Tronix286/a2vga_audio/docs/photo_2024-11-19_14-51-54.jpg

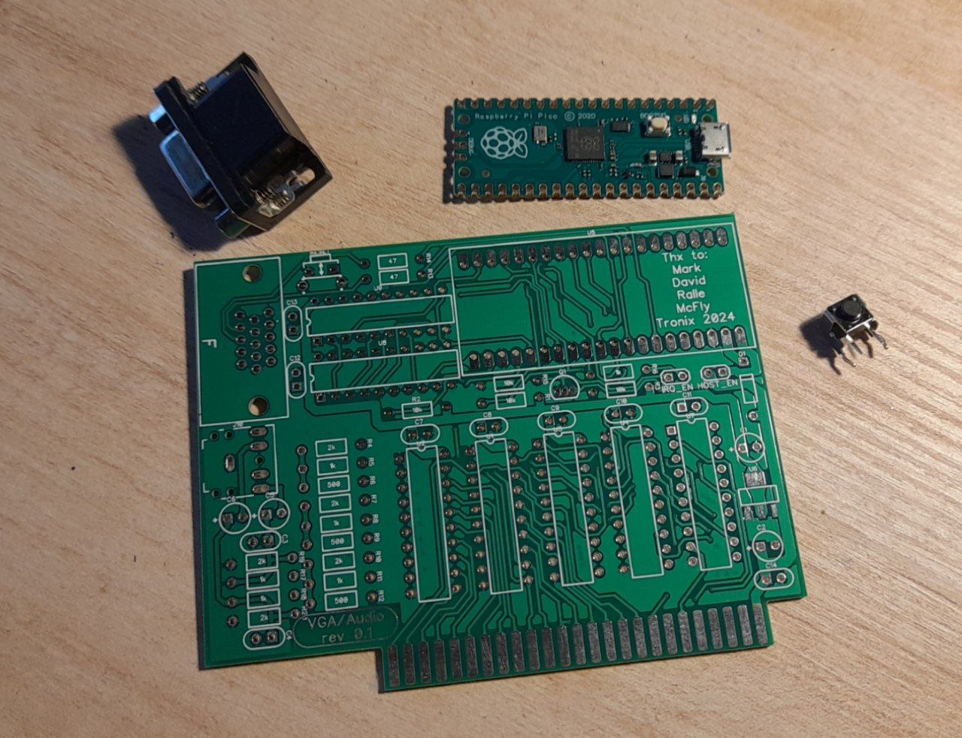
docs/photo_2024-11-19_14-51-54.jpg
