Tronix286/a2vga_audio/docs/photo_2024-11-20_11-59-58.jpg

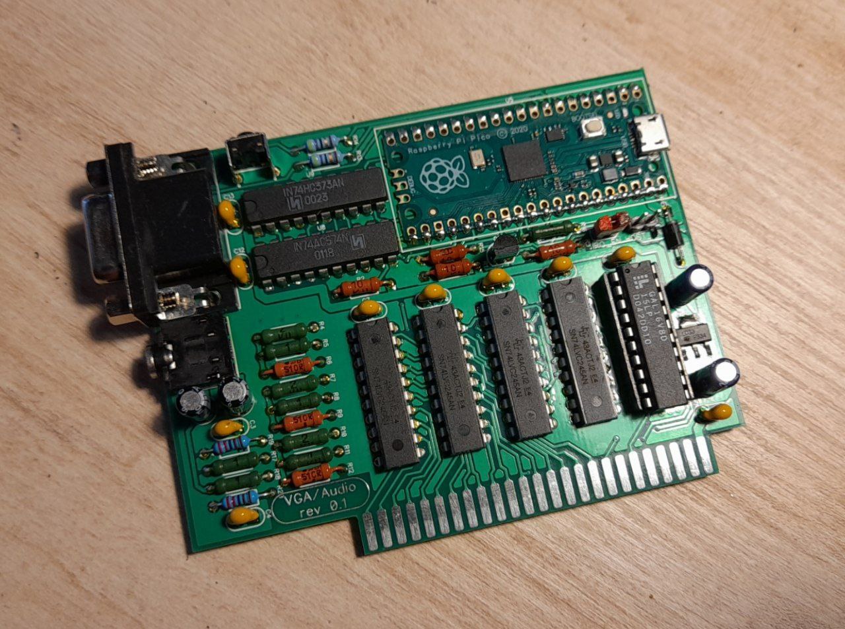
docs/photo_2024-11-20_11-59-58.jpg
