Tronix286/a2vga_audio/docs/photo_2024-11-20_12-00-19.jpg

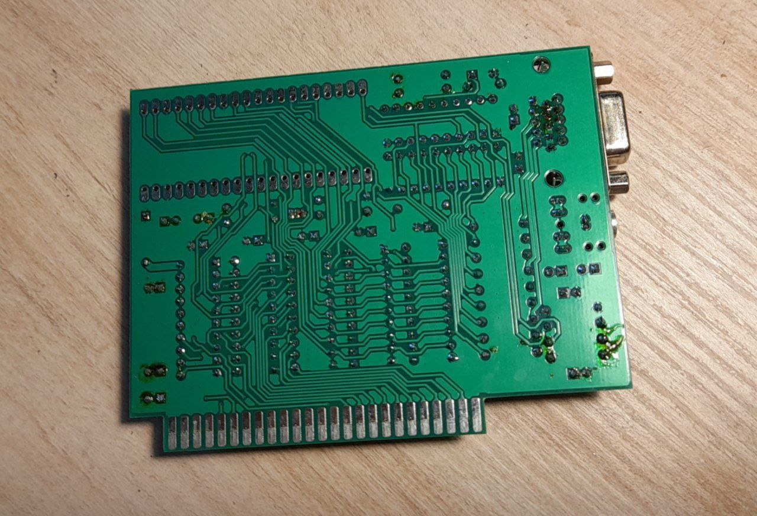
docs/photo_2024-11-20_12-00-19.jpg
