Tronix286/a2vga_audio/(threads)

Thread 1 (2025-02-06):

Components

amazingcobrazil, 2025-02-06:
Hello,
I'm finishing assembling my board but I have some questions:
1) What is the value of diode D1? 1N4001?
2) The schematic says that ICs U1, U2, U3 and U4 are 74HC245 and in the photos of your board you used 74LVC245 (much harder to find). Can I use HC?

Tronix286, 2025-02-06:
Hello,
I am using schottky 1N5817 but that doesn't matter. 1N4001 will do just fine.
U1,U2,U3 and U4 iam using 74LVC245. I'm not sure that 74HC245 will work, I haven't checked. Maybe yes, maybe no. It's better to use LVC series.

amazingcobrazil, 2025-02-06:
What about the firmware? Which of them is available that already works with the Mockingboard? Will the board work with both features together? (VGA + Mockingboard) or will it have to work separately by changing the firmware?
Congratulations on the project!

Tronix286, 2025-02-07:
> What about the firmware? Which of them is available that already works with the Mockingboard? Will the board work with both features together? (VGA + Mockingboard) or will it have to work separately by changing the firmware? Congratulations on the project!

Two options:
1) a2vga+mockingboard. First step you need burn [v2-analog-preloader.uf2](firmware/Release/v2-analog-preloader.uf2) It will prepare and install the fonts into pico flash and then blink the LED a couple of times. Then second step is burn [v2-analog-lc-4ns-vga.uf2](firmware/Release/v2-analog-lc-4ns-vga.uf2) - its main a2vga+mockingboard firmware. Set the jumper IRQ_EN to ON. Install card into slot #4. Thats all, you get VGA output plus Mockingboard at the same time.
2) Original Apple II VGA firmware modified for this PCB. Burn [applevga.uf2](firmware/Release/applevga.uf2). Its NOT support Mockingboard, VGA output only. But if the Videx 80 column card is installed this firmware can display 80x25 text mode (PR#3) and the previous firmware (a2vga+mockingboard) can't do it.

Firmware for GAL16V8 you can download from [∀2 Retro Computing](https://github.com/V2RetroComputing/analog), so direct link is [picopal](https://github.com/V2RetroComputing/picopal-v1/blob/dbde4b1a4bb3d2647ef39bca39bba3fad3cf1425/picopal.pld)

amazingcobrazil, 2025-03-14:
I would like to thank you in advance for your help. I was able to finalize my board for testing. I had the following situations on my board:

1) The colors of the firmware I downloaded here are apparently in PAL standard. Note in the photos I attached that in Karateka the image in the background is green instead of blue in the NTSC of another VGA board. Would it be possible to add another Firmware to the project or tell me where I can change this?

2) In the Mockingbird option I was able to make it work in very few games. In fact I only managed to do it in a demonstration from “Canada” that I found here on GitHub. Could you tell me what model of the emulated board would be? Who developed this firmware that runs on your board? It would be great if they found a way to increase board compatibility. Could you tell me which games you were successful in? I saw your test on YouTube but I couldn't get Última IV to run on mine. What other game did you use in the test?

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

Tronix286, 2025-03-14:
> 1. The colors of the firmware I downloaded here are apparently in PAL standard. Note in the photos I attached that in Karateka the image in the background is green instead of blue in the NTSC of another VGA board. Would it be possible to add another Firmware to the project or tell me where I can change this?

Original a2vga PIOs worked at a pixel clock frequency of ~25 MHz, then when sequentially loading values   into two registers in my board, a frequency twice as high is required - 50 MHz(!). This is most likely almost the maximum frequency for the 74**HC** IC series, so it is better to use something faster, for example, the 74AC or 74ACT series. Thus, for proper color decoding very important use "fast" logic IC for U8 (74xx574), U9 (74xx373). In my case I used what I had on hand, namely 74HC373 and 74AC574.  At your photo, chip 74**LS**373 will **not work** as expected i think. Try to change this with 74**HC**373. Thats all you need for proper color decoding.

> 2. In the Mockingbird option I was able to make it work in very few games. In fact I only managed to do it in a demonstration from “Canada” that I found here on GitHub. Could you tell me what model of the emulated board would be? Who developed this firmware that runs on your board? It would be great if they found a way to increase board compatibility. Could you tell me which games you were successful in? I saw your test on YouTube but I couldn't get Última IV to run on mine. What other game did you use in the test?

Unfortunately there are not many games that support Mockingboard. I don't remember all the games I've tried, there is a table of games that support mockingboard somewhere on the net. Sometimes in games you need to press a key combination like CTRL+S or something else to activate the mockingboard. Sometimes a special version of the game that supports mockingboard is required and this version is not always available on the Total Replay collection. I have heard sound to some extent in games like:
- Apple Cider Spider (ctrl+b for MB activation)
- Berzap! (ctrl+c for sound options)
- Bouncing Kamungas (ctrl+s for MB)
- Flak (special version)
- Lady Tut (special version, need 65C02 CPU for load)
- Lancaster (special version)
- Mapple
- Night Flight / Battle Cruiser SMS 2000
- One on One
- Skyfox (need joystick?)
- Spy Strikes Back!, The
- Thunder Bombs (ctrl+s act MB)
- Ultima IV – Quest of the Avatar
- Ultima V – Warriors of Destiny (need Apple IIe/c)
- Willy Byte in the Digital Dimension

Iam author of MB emulation code for a2vga firmware. I emulate "Mockingboard A".

Thread 2 (2025-03-21):

missing colors on vga output?

timspc1980, 2025-03-21:
Hi and thanks for this cool project,only just getting back into the A2 so I have managed to put one of these together but the colors dont look correct (almost like its missing a few colors) and there is a blue fringe around text which is not white but rather purple/dark pink?

Have tried different logic chip series for U8 and U9 (74HC/74HCT/74F) but no change? I am waiting for some AC/ACT to test as per your recommendation but can you confirm the colors on your card is working? Any other things to look at ?

FYI - Q1 (c9013) I could only find 2n3904 in my parts bin would this be ok as a replacement?

The mockingboard part is working well, great sound brings back memories from the past when I had one, love it!

Thanks

Tronix286, 2025-03-21:
> Hi and thanks for this cool project,only just getting back into the A2 so I have managed to put one of these together but the colors dont look correct (almost like its missing a few colors) and there is a blue fringe around text which is not white but rather purple/dark pink?
> Have tried different logic chip series for U8 and U9 (74HC/74HCT/74F) but no change? I am waiting for some AC/ACT to test as per your recommendation but can you confirm the colors on your card is working? Any other things to look at ?

Hm.... In my opinion, there are possible reasons:
 1) the firmware is not from this page, perhaps the original a2vga or some other one. It is necessary to make sure that the pipico is flashed with the firmware from this page from the [this section](firmware/Release) . First flash [v2-analog-preloader.uf2](https://github.com/Tronix286/a2vga_audio/blob/main/firmware/Release/v2-analog-preloader.uf2) then burn main a2vga+audio formware [v2-analog-lc-4ns-vga.uf2](https://github.com/Tronix286/a2vga_audio/blob/main/firmware/Release/v2-analog-lc-4ns-vga.uf2) . Also you can try [applevga.uf2](https://github.com/Tronix286/a2vga_audio/blob/main/firmware/Release/applevga.uf2) - this firmware dosnt support mockingboard, but compiled for this PCB exactly.
2) yes,  U8 and U9 should be as fast as possible. Sometimes the Chinese re-mark the chips, so if you order them from AliExpress, it is not a fact that the marking corresponds to the real chip. They can sell HC as LS marking or vice versa. Therefore, original fast chips are needed, HC (not sure) or AC or ACT series.
3) check the soldering, and that the resistors match the required ratings.
4) Your PiPico does not support overclocking well. The thing is that my firmware works with overclocking, unlike the original a2vga firmware, and I heard that not all PiPico boards tolerate overclocking well. On the other hand, if you see a picture on the monitor, then your PiPico works at the required frequencies. So it is unlikely.

Can you provide examples of pictures on your system?
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

Q1 is needed for IRQ generating circuit for mockingboard emulation, so if you hear sounds then the transistor Q1 is fine.

timspc1980, 2025-03-22:
hi again and thanks for replying...

1. I used your uf2 files , tried both vga+mock and vga only and both show same color output almost washed out/dull with a blue tinge around the text? I did notice the vga only fw shows % sign instead of IIe, not sure why as the vga+mock shows correctly... I used the picopal.jed file from original a2analog. FYI Im using a USA NTSC IIe enh

2. Parts are all genuine from mouser here in usa inc the pico ;-), and yes the mockingboard side functions perfectly.
3. soldering all good I checked with your schematic everything correct

4.I did do a test by powering up the card via the pico usb and connected to vga monitor (outside of the apple) and the a2 logo with IIe computer display came up all in red and a red box next to it?

The only thing I can think of is that the resistors used are a mix of 1% and 5% tolerance would this cause an issue with the color output ? Also I only had a 510R resistor instead of 500R.

Will test with AC/ACT series and report back and I try put some pics up

timspc1980, 2025-03-23:
Hi, I checked data sheets of the series used on your card (U8 HC/ U9 AC) and the speeds are very close to the series I tested (HC/HCT and F series) but I may have some LVC from some old pc cards that I will try find, they are even faster. But I agree if you can test your card using different series would help.

BTW I did notice your card is Ver 0.1? Has anything changed in Ver 0.2 or have you been able to build a Ver 0.2 to test.

Tronix286, 2025-03-25:
> BTW I did notice your card is Ver 0.1? Has anything changed in Ver 0.2 or have you been able to build a Ver 0.2 to test.
Hi, нhe only difference between the second revision and the first is the adjusted size of the edge card connector. In the first version, the edge slot was smaller than necessary in width, in the second version the indents are aligned. There are no other differences. I myself did not order or assemble the second version.

Tronix286, 2025-03-25:
> But I agree if you can test your card using different series would help.

Unfortunately, I don't have the opportunity to buy any original series of 74 logic IC now. But I found several options:
U8
IN74AC574AN - "Integral", Belarus
SN74HCT574N - "Texas Instruments"

U9
IN74HC373AN - "Integral", Belarus
K555IR22 - "USSR", 74LS373 analog
GD74LS373 - "GoldStar"

So,
IN74HC373AN + IN74AC574AN = fine color, white text on black screen; REFERENCE;
555IR22 + IN74AC574AN = white text with a blue fringe around text;
GD74LS373 + IN74AC574AN = yellow text on black screen, missing colors;
and
IN74HC373AN + SN74HCT574N = white text with a red fringe around text;

For some reason i cant attach sample images now. But experiments have shown that the IN74HC373AN + IN74AC574AN works best. Any other chips i have didn't work as they should.

timspc1980, 2025-04-05:
Thanks so much for testing different series , I have tried a number of different combinations with parts I have and color is good now :-) thanks again for great project!

Closed 2025-04-05.

Thread 3 (2025-05-21):

Proposals

greukik, 2025-05-21:
Hello.
I just finished mounting this card. The vga output is amazing, thanks!

May I ha umbly suggest to update the readme file with some important informations hard to find without looking at the schematics on a dedicated software.
Some answers are indeed in the other issue question.

My difficulties were:
No BOM (but I managed to make one , looking at the technical schemes)

No GAL .jed file. You gave in the issue questions a link to a non compiled file and the compiler wincupl is not available anymore on microchip website. Had some difficulties to make a .jed file for the t48 while wincupl is currently not so easy to find on the web... And it asked a serial number... That is given on the microchip forum 🤡. So much time lost  😁.

Some minor corrections (R 500 is in fact a R 510) and some caps are noted only "0.1" without unity. By default my hypothesis was uF but some of them are noted 100nF so it was confusing for a non professionnal like me. Didn't want to make mistakes.
And finaly, could you explain the role of the 2 jumpers?

By the way, it is a very nice card you designed here and I can only thank you a bilion times for this.

Best regards.

Tronix286, 2025-10-05:
Some improvements have been made.

Thread 4 (2025-05-22):

another idea?

greukik, 2025-05-22:
Hello again.
I was guessing that it would be fun to use this card on a rgb 15khz monitor.
Would it be possible to change the code of the pi in order to be able to use it, for example, on an apple rgb display or simply a classic 15khz pal crt ?
It won't be a big problem to make a vgaDE9-15pins to rgb DE-9 9 pins or apple 15 pin adapter.

Best regards.
