Tronix286/a2vga_audio/hardware/a2vga_audio_rev_0_2.dch Sheet 1.pdf

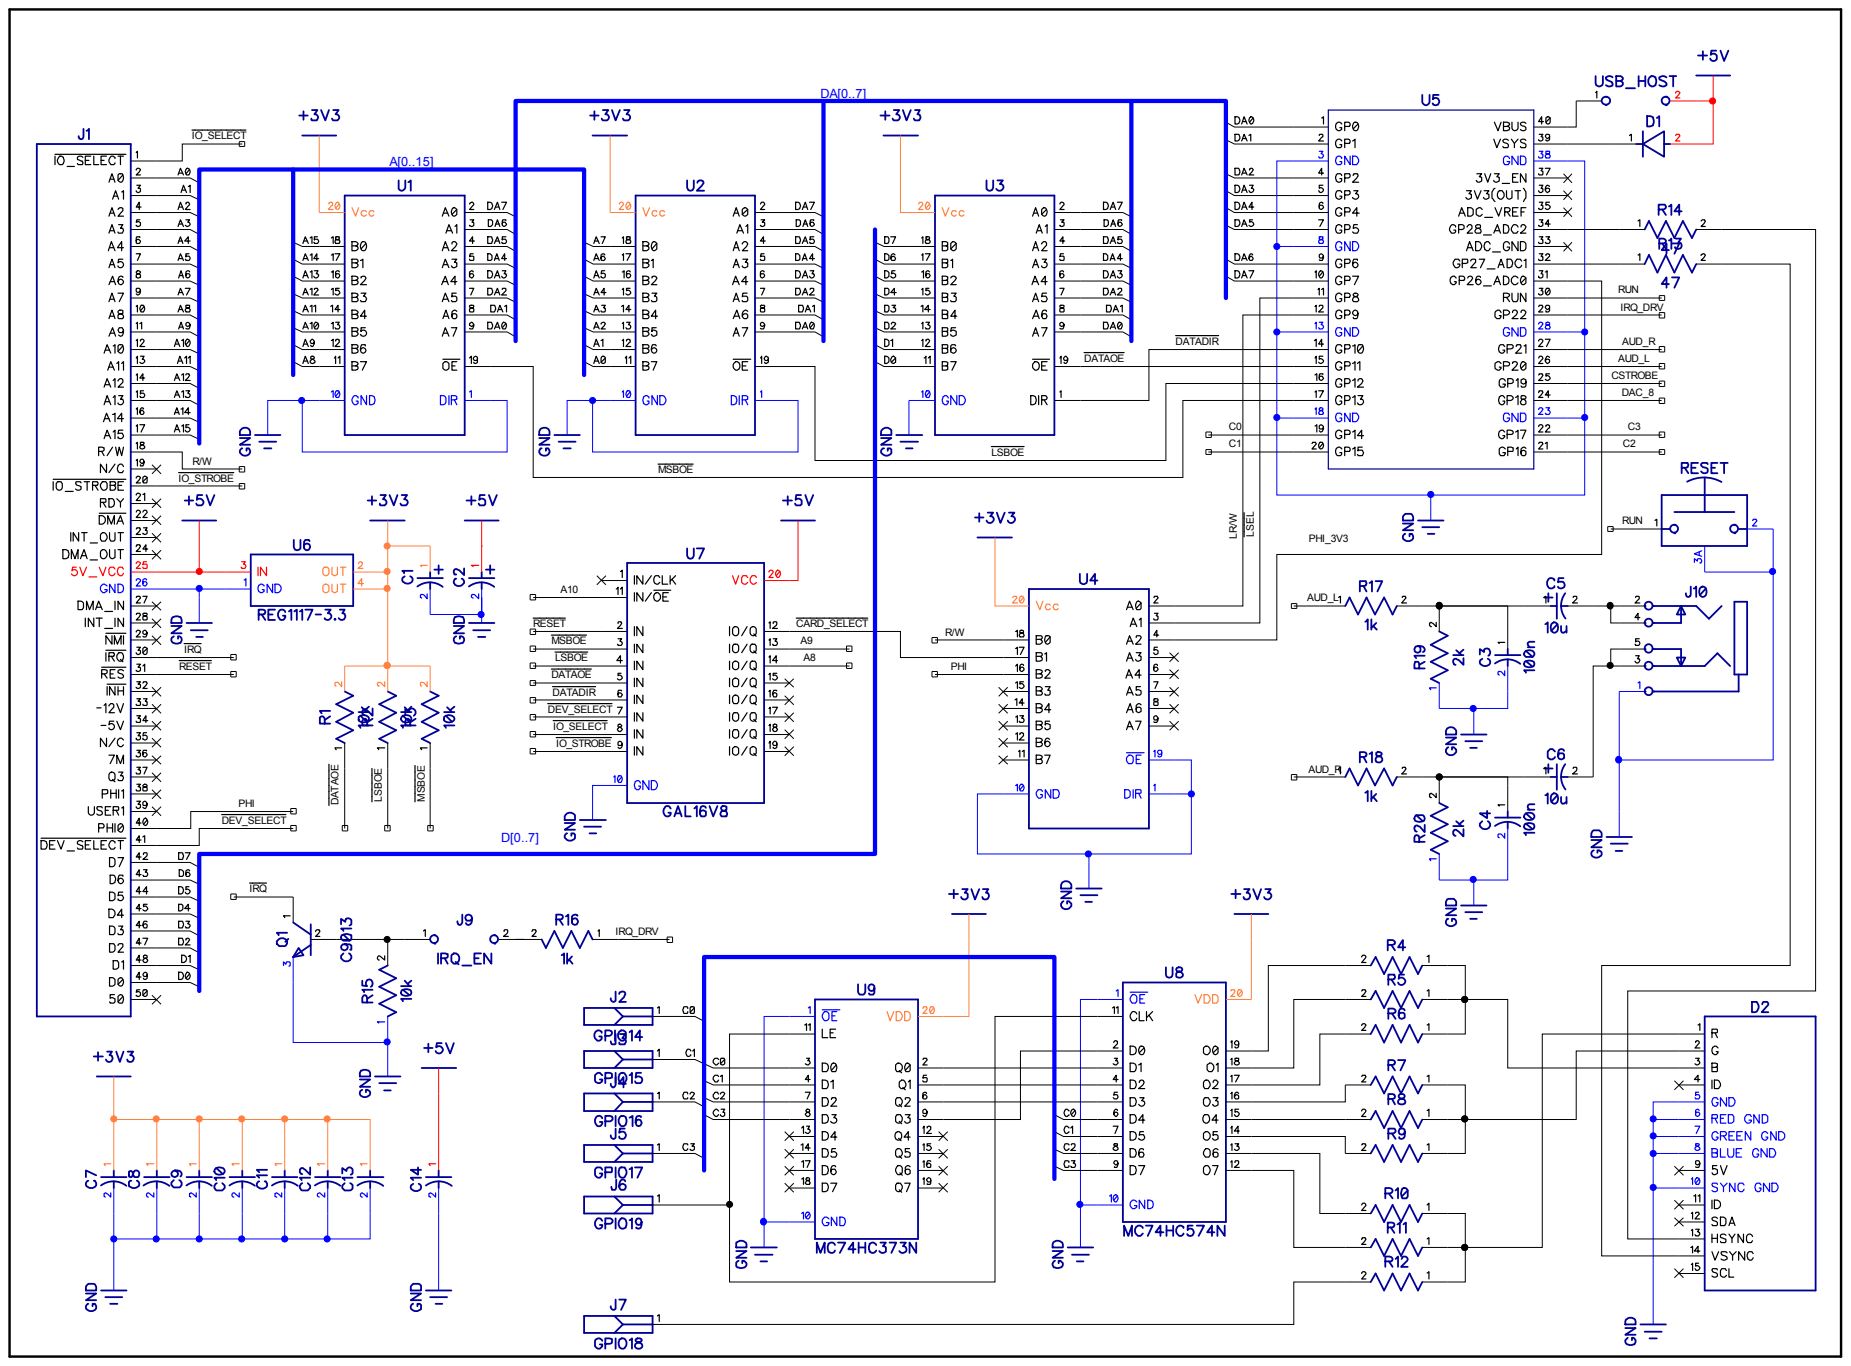
[picture p6: page 1]
PHI; DEV_SELECT; CARD_SELECT; RESET; MSBOE; LSBOE; DATAOE; DATADIR; IO_SELECT; IO_STROBE; PHI_3V3; LSEL; DAC_8; CSTROBE; IRQ; IRQ_DRV; RUN; AUD_L; AUD_R
