Tronix286/a2vga_audio/(list of files, drawings)

Other design files:
hardware/a2vga_audio.dch
hardware/a2vga_audio.dip
hardware/a2vga_audio_rev_0_2.dch
hardware/a2vga_audio_rev_0_2.dip
hardware/a2vga_audio_rev_0_3.dip
