Tronix286/a2vga_audio/firmware/analog-firmware-main-lc-4ns-vga/vga/dhgr_patterns.h

uint8_t dhgr_pixel_table[4096] = {
  0xf0, // 000000000000 Blk Blk Blk 
  0xf0, // 000000000001 Blk Blk DBlu
  0xf0, // 000000000010 Blk Blk DGrn
  0xf0, // 000000000011 Blk Blk HBlu
  0xf0, // 000000000100 Blk Blk Bro 
  0xf0, // 000000000101 Blk Blk LGry
  0xf0, // 000000000110 Blk Blk HGrn
  0xf0, // 000000000111 Blk Blk Aqua
  0xf0, // 000000001000 Blk Blk Mag 
  0xf0, // 000000001001 Blk Blk HVio
  0xf0, // 000000001010 Blk Blk DGry
  0xf0, // 000000001011 Blk Blk LBlu
  0xf0, // 000000001100 Blk Blk HOra
  0xf0, // 000000001101 Blk Blk Pink
  0xf0, // 000000001110 Blk Blk Yel 
  0xf0, // 000000001111 Blk Blk Whit
  0x61, // 000000010000 Blk DBluBlk 
  0xf1, // 000000010001 Blk DBluDBlu
  0xf1, // 000000010010 Blk DBluDGrn
  0xf1, // 000000010011 Blk DBluHBlu
  0xf1, // 000000010100 Blk DBluBro 
  0xf1, // 000000010101 Blk DBluLGry
  0xf1, // 000000010110 Blk DBluHGrn
  0xf1, // 000000010111 Blk DBluAqua
  0xf1, // 000000011000 Blk DBluMag 
  0xf1, // 000000011001 Blk DBluHVio
  0xf1, // 000000011010 Blk DBluDGry
  0xf1, // 000000011011 Blk DBluLBlu
  0xf1, // 000000011100 Blk DBluHOra
  0xf1, // 000000011101 Blk DBluPink
  0xf1, // 000000011110 Blk DBluYel 
  0x1f, // 000000011111 Blk DBluWhit
  0x62, // 000000100000 Blk DGrnBlk 
  0xf2, // 000000100001 Blk DGrnDBlu
  0xf2, // 000000100010 Blk DGrnDGrn
  0xf2, // 000000100011 Blk DGrnHBlu
  0xf2, // 000000100100 Blk DGrnBro 
  0xf2, // 000000100101 Blk DGrnLGry
  0xf2, // 000000100110 Blk DGrnHGrn
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
  0xf9, // 110010011111 HOraHVioWhit
  0xfa, // 110010100000 HOraDGryBlk 
  0xfa, // 110010100001 HOraDGryDBlu
  0xfa, // 110010100010 HOraDGryDGrn
  0xfa, // 110010100011 HOraDGryHBlu
  0xfa, // 110010100100 HOraDGryBro 
  0xfa, // 110010100101 HOraDGryLGry
  0xfa, // 110010100110 HOraDGryHGrn
  0xfa, // 110010100111 HOraDGryAqua
  0xfa, // 110010101000 HOraDGryMag 
  0xfa, // 110010101001 HOraDGryHVio
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
