Tronix286/a2vga_audio/firmware/analog-firmware-main-lc-4ns-vga/vga/hires_color_patterns.h

#pragma once

#include "common/config.h"
#include "vga/render.h"

#define _PIXELS(color1, color2) ((uint32_t)(color1) | ((uint32_t)(color2) << 16))

static uint32_t DELAYED_COPY_DATA(hires_color_patterns)[2*256] = {
    // Even byte pixels
    /* 0b00000000 */ _PIXELS(RGB_BLACK, RGB_BLACK),
    /* 0b00000001 */ _PIXELS(RGB_BLACK, RGB_BLACK),
    /* 0b00000010 */ _PIXELS(RGB_BLACK, RGB_BLACK),
    /* 0b00000011 */ _PIXELS(RGB_BLACK, RGB_BLACK),
    /* 0b00000100 */ _PIXELS(RGB_BLACK, RGB_BLACK),
    /* 0b00000101 */ _PIXELS(RGB_BLACK, RGB_BLACK),
    /* 0b00000110 */ _PIXELS(RGB_BLACK, RGB_BLACK),
    /* 0b00000111 */ _PIXELS(RGB_BLACK, RGB_BLACK),
    /* 0b00001000 */ _PIXELS(RGB_BLACK, RGB_DBLUE),
    /* 0b00001001 */ _PIXELS(RGB_BLACK, _RGB(0x90, 0x24, 0xD8)),
    /* 0b00001010 */ _PIXELS(RGB_BLACK, _RGB(0x90, 0x90, 0x90)),
    /* 0b00001011 */ _PIXELS(RGB_BLACK, _RGB(0xD8, 0x6C, 0xD8)),
    /* 0b00001100 */ _PIXELS(RGB_BLACK, _RGB(0x00, 0x90, 0xFC)),
    /* 0b00001101 */ _PIXELS(RGB_BLACK, _RGB(0x48, 0x6C, 0xFC)),
    /* 0b00001110 */ _PIXELS(RGB_BLACK, _RGB(0x90, 0xFC, 0xB4)),
    /* 0b00001111 */ _PIXELS(RGB_BLACK, RGB_WHITE),
    /* 0b00010000 */ _PIXELS(_RGB(0x6C, 0x00, 0x6C), RGB_BLACK),
    /* 0b00010001 */ _PIXELS(_RGB(0x6C, 0x00, 0x6C), _RGB(0x6C, 0x00, 0x6C)),
    /* 0b00010010 */ _PIXELS(_RGB(0xD8, 0x24, 0x24), _RGB(0xFC, 0x48, 0x00)),
    /* 0b00010011 */ _PIXELS(_RGB(0xD8, 0x24, 0x24), _RGB(0xFC, 0x48, 0x00)),
    /* 0b00010100 */ _PIXELS(_RGB(0x48, 0x48, 0x48), _RGB(0x48, 0x48, 0x48)),
    /* 0b00010101 */ _PIXELS(_RGB(0x48, 0x48, 0x48), _RGB(0x48, 0x48, 0x48)),
    /* 0b00010110 */ _PIXELS(_RGB(0xB4, 0xB4, 0x24), _RGB(0xD8, 0xD8, 0x00)),
    /* 0b00010111 */ _PIXELS(_RGB(0xB4, 0xB4, 0x24), _RGB(0xD8, 0xD8, 0x00)),
    /* 0b00011000 */ _PIXELS(_RGB(0xB4, 0x24, 0xFC), _RGB(0xB4, 0x24, 0xFC)),
    /* 0b00011001 */ _PIXELS(_RGB(0xB4, 0x24, 0xFC), _RGB(0xB4, 0x24, 0xFC)),
    /* 0b00011010 */ _PIXELS(_RGB(0xD8, 0x48, 0xFC), RGB_PINK),
    /* 0b00011011 */ _PIXELS(_RGB(0xD8, 0x48, 0xFC), RGB_PINK),
    /* 0b00011100 */ _PIXELS(_RGB(0x6C, 0x6C, 0xFC), _RGB(0x6C, 0x6C, 0xFC)),
    /* 0b00011101 */ _PIXELS(_RGB(0x6C, 0x6C, 0xFC), _RGB(0x6C, 0x6C, 0xFC)),
    /* 0b00011110 */ _PIXELS(RGB_WHITE, RGB_WHITE),
    /* 0b00011111 */ _PIXELS(RGB_WHITE, RGB_WHITE),
    /* 0b00100000 */ _PIXELS(RGB_BLACK, RGB_BLACK),
    /* 0b00100001 */ _PIXELS(RGB_BLACK, RGB_BLACK),
    /* 0b00100010 */ _PIXELS(_RGB(0x24, 0x24, 0x00), _RGB(0x24, 0x24, 0x00)),
    /* 0b00100011 */ _PIXELS(_RGB(0x24, 0x24, 0x00), _RGB(0xB4, 0x48, 0x00)),
    /* 0b00100100 */ _PIXELS(_RGB(0x00, 0x6C, 0x00), RGB_DGREEN),
    /* 0b00100101 */ _PIXELS(_RGB(0x00, 0x6C, 0x00), _RGB(0x24, 0x48, 0x48)),
    /* 0b00100110 */ _PIXELS(_RGB(0x00, 0xD8, 0x24), _RGB(0x00, 0xD8, 0x24)),
    /* 0b00100111 */ _PIXELS(_RGB(0x00, 0xD8, 0x24), _RGB(0x90, 0xD8, 0x00)),
    /* 0b00101000 */ _PIXELS(_RGB(0x24, 0x24, 0xB4), RGB_DBLUE),
    /* 0b00101001 */ _PIXELS(_RGB(0x24, 0x24, 0xB4), _RGB(0x90, 0x24, 0xD8)),
    /* 0b00101010 */ _PIXELS(_RGB(0x90, 0x90, 0x90), _RGB(0x90, 0x90, 0x90)),
    /* 0b00101011 */ _PIXELS(_RGB(0x90, 0x90, 0x90), _RGB(0xD8, 0x6C, 0xD8)),
    /* 0b00101100 */ _PIXELS(_RGB(0x24, 0xB4, 0xD8), _RGB(0x00, 0x90, 0xFC)),
    /* 0b00101101 */ _PIXELS(_RGB(0x24, 0xB4, 0xD8), _RGB(0x48, 0x6C, 0xFC)),
    /* 0b00101110 */ _PIXELS(_RGB(0x90, 0xFC, 0xB4), _RGB(0x90, 0xFC, 0xB4)),
    /* 0b00101111 */ _PIXELS(_RGB(0x90, 0xFC, 0xB4), RGB_WHITE),
    /* 0b00110000 */ _PIXELS(_RGB(0x90, 0x24, 0x48), RGB_BLACK),
    /* 0b00110001 */ _PIXELS(_RGB(0x90, 0x24, 0x48), _RGB(0x6C, 0x00, 0x6C)),
    /* 0b00110010 */ _PIXELS(_RGB(0xFC, 0x48, 0x00), _RGB(0xFC, 0x48, 0x00)),
    /* 0b00110011 */ _PIXELS(_RGB(0xFC, 0x48, 0x00), _RGB(0xFC, 0x48, 0x00)),
    /* 0b00110100 */ _PIXELS(_RGB(0x6C, 0x6C, 0x24), _RGB(0x48, 0x48, 0x48)),
    /* 0b00110101 */ _PIXELS(_RGB(0x6C, 0x6C, 0x24), _RGB(0x48, 0x48, 0x48)),
    /* 0b00110110 */ _PIXELS(_RGB(0xD8, 0xD8, 0x00), _RGB(0xD8, 0xD8, 0x00)),
    /* 0b00110111 */ _PIXELS(_RGB(0xD8, 0xD8, 0x00), _RGB(0xD8, 0xD8, 0x00)),
    /* 0b00111000 */ _PIXELS(_RGB(0xB4, 0x48, 0xFC), _RGB(0xB4, 0x24, 0xFC)),
    /* 0b00111001 */ _PIXELS(_RGB(0xB4, 0x48, 0xFC), _RGB(0xB4, 0x24, 0xFC)),
    /* 0b00111010 */ _PIXELS(RGB_PINK, RGB_PINK),
    /* 0b00111011 */ _PIXELS(RGB_PINK, RGB_PINK),
    /* 0b00111100 */ _PIXELS(RGB_WHITE, RGB_WHITE),
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
    /* 0b11010010 */ _PIXELS(_RGB(0xD8, 0x48, 0x48), _RGB(0xFC, 0x48, 0x00)),
    /* 0b11010011 */ _PIXELS(_RGB(0xD8, 0x48, 0x48), _RGB(0xFC, 0x48, 0x00)),
    /* 0b11010100 */ _PIXELS(_RGB(0x48, 0x48, 0x6C), _RGB(0x48, 0x48, 0x48)),
    /* 0b11010101 */ _PIXELS(_RGB(0x48, 0x48, 0x6C), _RGB(0x48, 0x48, 0x48)),
    /* 0b11010110 */ _PIXELS(_RGB(0xB4, 0xB4, 0x48), _RGB(0xD8, 0xD8, 0x00)),
    /* 0b11010111 */ _PIXELS(_RGB(0xB4, 0xB4, 0x48), _RGB(0xD8, 0xD8, 0x00)),
    /* 0b11011000 */ _PIXELS(_RGB(0x90, 0x48, 0xFC), _RGB(0xB4, 0x24, 0xFC)),
    /* 0b11011001 */ _PIXELS(_RGB(0x90, 0x48, 0xFC), _RGB(0xB4, 0x24, 0xFC)),
    /* 0b11011010 */ _PIXELS(_RGB(0xD8, 0x6C, 0xFC), RGB_PINK),
    /* 0b11011011 */ _PIXELS(_RGB(0xD8, 0x6C, 0xFC), RGB_PINK),
    /* 0b11011100 */ _PIXELS(_RGB(0x6C, 0x6C, 0xFC), _RGB(0x6C, 0x6C, 0xFC)),
    /* 0b11011101 */ _PIXELS(_RGB(0x6C, 0x6C, 0xFC), _RGB(0x6C, 0x6C, 0xFC)),
    /* 0b11011110 */ _PIXELS(RGB_WHITE, RGB_WHITE),
    /* 0b11011111 */ _PIXELS(RGB_WHITE, RGB_WHITE),
    /* 0b11100000 */ _PIXELS(RGB_BLACK, RGB_BLACK),
    /* 0b11100001 */ _PIXELS(RGB_BLACK, RGB_BLACK),
    /* 0b11100010 */ _PIXELS(_RGB(0x48, 0x6C, 0x24), _RGB(0x24, 0x24, 0x00)),
    /* 0b11100011 */ _PIXELS(RGB_BLACK, RGB_BLACK), //_PIXELS(_RGB(0x48, 0x6C, 0x24), _RGB(0xB4, 0x48, 0x00)),
    /* 0b11100100 */ _PIXELS(_RGB(0x24, 0x6C, 0x24), RGB_DGREEN),
    /* 0b11100101 */ _PIXELS(_RGB(0x24, 0x6C, 0x24), _RGB(0x24, 0x48, 0x48)),
    /* 0b11100110 */ _PIXELS(_RGB(0x24, 0xD8, 0x48), _RGB(0x00, 0xD8, 0x24)),
    /* 0b11100111 */ _PIXELS(RGB_BLACK, RGB_BLACK), //_PIXELS(_RGB(0x24, 0xD8, 0x48), _RGB(0x90, 0xD8, 0x00)),
    /* 0b11101000 */ _PIXELS(_RGB(0x24, 0x48, 0xB4), _RGB(0x00, 0x24, 0xB4)),
    /* 0b11101001 */ _PIXELS(_RGB(0x24, 0x48, 0xB4), _RGB(0x90, 0x24, 0xD8)),
    /* 0b11101010 */ _PIXELS(_RGB(0x90, 0xB4, 0x90), _RGB(0x90, 0x90, 0x90)),
    /* 0b11101011 */ _PIXELS(_RGB(0x90, 0xB4, 0x90), _RGB(0xD8, 0x6C, 0xD8)),
    /* 0b11101100 */ _PIXELS(_RGB(0x24, 0xB4, 0xD8), _RGB(0x00, 0x90, 0xFC)),
    /* 0b11101101 */ _PIXELS(_RGB(0x24, 0xB4, 0xD8), _RGB(0x48, 0x6C, 0xFC)),
    /* 0b11101110 */ _PIXELS(_RGB(0x90, 0xFC, 0xB4), _RGB(0x90, 0xFC, 0xB4)),
    /* 0b11101111 */ _PIXELS(_RGB(0x90, 0xFC, 0xB4), RGB_WHITE),
    /* 0b11110000 */ _PIXELS(RGB_WHITE, RGB_BLACK),
    /* 0b11110001 */ _PIXELS(RGB_WHITE, _RGB(0x6C, 0x00, 0x6C)),
    /* 0b11110010 */ _PIXELS(RGB_WHITE, _RGB(0xFC, 0x48, 0x00)),
    /* 0b11110011 */ _PIXELS(RGB_WHITE, _RGB(0xFC, 0x48, 0x00)),
    /* 0b11110100 */ _PIXELS(RGB_WHITE, _RGB(0x48, 0x48, 0x48)),
    /* 0b11110101 */ _PIXELS(RGB_WHITE, _RGB(0x48, 0x48, 0x48)),
    /* 0b11110110 */ _PIXELS(RGB_WHITE, _RGB(0xD8, 0xD8, 0x00)),
    /* 0b11110111 */ _PIXELS(RGB_WHITE, _RGB(0xD8, 0xD8, 0x00)),
    /* 0b11111000 */ _PIXELS(RGB_WHITE, RGB_WHITE),
    /* 0b11111001 */ _PIXELS(RGB_WHITE, RGB_WHITE),
    /* 0b11111010 */ _PIXELS(RGB_WHITE, RGB_WHITE),
    /* 0b11111011 */ _PIXELS(RGB_WHITE, RGB_WHITE),
    /* 0b11111100 */ _PIXELS(RGB_WHITE, RGB_WHITE),
    /* 0b11111101 */ _PIXELS(RGB_WHITE, RGB_WHITE),
    /* 0b11111110 */ _PIXELS(RGB_WHITE, RGB_WHITE),
    /* 0b11111111 */ _PIXELS(RGB_WHITE, RGB_WHITE),

    // Odd byte pixels
    /* 0b00000000 */ _PIXELS(RGB_BLACK, RGB_BLACK),
    /* 0b00000001 */ _PIXELS(RGB_BLACK, RGB_BLACK),
    /* 0b00000010 */ _PIXELS(RGB_BLACK, RGB_BLACK),
    /* 0b00000011 */ _PIXELS(RGB_BLACK, RGB_BLACK),
    /* 0b00000100 */ _PIXELS(RGB_BLACK, RGB_BLACK),
    /* 0b00000101 */ _PIXELS(RGB_BLACK, RGB_BLACK),
    /* 0b00000110 */ _PIXELS(RGB_BLACK, RGB_BLACK),
    /* 0b00000111 */ _PIXELS(RGB_BLACK, RGB_BLACK),
    /* 0b00001000 */ _PIXELS(RGB_BLACK, _RGB(0x24, 0x24, 0x00)),
    /* 0b00001001 */ _PIXELS(RGB_BLACK, _RGB(0x00, 0xB4, 0x24)),
    /* 0b00001010 */ _PIXELS(RGB_BLACK, _RGB(0x90, 0x90, 0x90)),
    /* 0b00001011 */ _PIXELS(RGB_BLACK, _RGB(0x90, 0xD8, 0x90)),
    /* 0b00001100 */ _PIXELS(RGB_BLACK, _RGB(0xFC, 0x48, 0x00)),
    /* 0b00001101 */ _PIXELS(RGB_BLACK, _RGB(0xD8, 0xB4, 0x00)),
    /* 0b00001110 */ _PIXELS(RGB_BLACK, _RGB(0xFC, 0x6C, 0xD8)),
    /* 0b00001111 */ _PIXELS(RGB_BLACK, RGB_WHITE),
    /* 0b00010000 */ _PIXELS(RGB_DGREEN, RGB_BLACK),
    /* 0b00010001 */ _PIXELS(RGB_DGREEN, RGB_DGREEN),
    /* 0b00010010 */ _PIXELS(_RGB(0x00, 0x6C, 0xB4), _RGB(0x00, 0x90, 0xD8)),
    /* 0b00010011 */ _PIXELS(_RGB(0x00, 0x6C, 0xB4), _RGB(0x00, 0x90, 0xD8)),
    /* 0b00010100 */ _PIXELS(_RGB(0x48, 0x48, 0x48), _RGB(0x48, 0x48, 0x48)),
    /* 0b00010101 */ _PIXELS(_RGB(0x48, 0x48, 0x48), _RGB(0x48, 0x48, 0x48)),
    /* 0b00010110 */ _PIXELS(_RGB(0x6C, 0x6C, 0xB4), _RGB(0x6C, 0x6C, 0xFC)),
    /* 0b00010111 */ _PIXELS(_RGB(0x6C, 0x6C, 0xB4), _RGB(0x6C, 0x6C, 0xFC)),
    /* 0b00011000 */ _PIXELS(_RGB(0x00, 0xD8, 0x24), _RGB(0x00, 0xD8, 0x24)),
    /* 0b00011001 */ _PIXELS(_RGB(0x00, 0xD8, 0x24), _RGB(0x00, 0xD8, 0x24)),
    /* 0b00011010 */ _PIXELS(_RGB(0x6C, 0x90, 0xFC), _RGB(0x90, 0xFC, 0xB4)),
    /* 0b00011011 */ _PIXELS(_RGB(0x6C, 0x90, 0xFC), _RGB(0x90, 0xFC, 0xB4)),
    /* 0b00011100 */ _PIXELS(_RGB(0xB4, 0xD8, 0x00), _RGB(0xD8, 0xD8, 0x00)),
    /* 0b00011101 */ _PIXELS(_RGB(0xB4, 0xD8, 0x00), _RGB(0xD8, 0xD8, 0x00)),
    /* 0b00011110 */ _PIXELS(RGB_WHITE, RGB_WHITE),
    /* 0b00011111 */ _PIXELS(RGB_WHITE, RGB_WHITE),
    /* 0b00100000 */ _PIXELS(RGB_BLACK, RGB_BLACK),
    /* 0b00100001 */ _PIXELS(RGB_BLACK, RGB_BLACK),
    /* 0b00100010 */ _PIXELS(RGB_DBLUE, RGB_DBLUE),
    /* 0b00100011 */ _PIXELS(RGB_DBLUE, _RGB(0x00, 0x6C, 0xD8)),
    /* 0b00100100 */ _PIXELS(_RGB(0xB4, 0x24, 0xFC), _RGB(0xB4, 0x24, 0xFC)),
    /* 0b00100101 */ _PIXELS(_RGB(0xB4, 0x24, 0xFC), _RGB(0x6C, 0x48, 0xFC)),
    /* 0b00100110 */ _PIXELS(_RGB(0xB4, 0x24, 0xFC), _RGB(0xB4, 0x24, 0xFC)),
    /* 0b00100111 */ _PIXELS(_RGB(0xB4, 0x24, 0xFC), _RGB(0x6C, 0x48, 0xFC)),
    /* 0b00101000 */ _PIXELS(_RGB(0x90, 0x90, 0x90), _RGB(0x90, 0x90, 0x90)),
    /* 0b00101001 */ _PIXELS(_RGB(0x90, 0x90, 0x90), _RGB(0x90, 0xD8, 0xB4)),
    /* 0b00101010 */ _PIXELS(_RGB(0x90, 0x90, 0x90), _RGB(0x90, 0x90, 0x90)),
    /* 0b00101011 */ _PIXELS(_RGB(0x90, 0x90, 0x90), _RGB(0x90, 0xD8, 0xB4)),
    /* 0b00101100 */ _PIXELS(RGB_PINK, RGB_PINK),
    /* 0b00101101 */ _PIXELS(RGB_PINK, _RGB(0xFC, 0xD8, 0xFC)),
    /* 0b00101110 */ _PIXELS(RGB_PINK, RGB_PINK),
    /* 0b00101111 */ _PIXELS(RGB_PINK, RGB_WHITE),
    /* 0b00110000 */ _PIXELS(_RGB(0x00, 0x90, 0xFC), RGB_BLACK),
    /* 0b00110001 */ _PIXELS(_RGB(0x00, 0x90, 0xFC), _RGB(0x00, 0x90, 0xFC)),
    /* 0b00110010 */ _PIXELS(_RGB(0x00, 0x90, 0xFC), _RGB(0x00, 0x90, 0xFC)),
    /* 0b00110011 */ _PIXELS(_RGB(0x00, 0x90, 0xFC), _RGB(0x00, 0x90, 0xFC)),
    /* 0b00110100 */ _PIXELS(_RGB(0x6C, 0x6C, 0xFC), _RGB(0x6C, 0x6C, 0xFC)),
    /* 0b00110101 */ _PIXELS(_RGB(0x6C, 0x6C, 0xFC), _RGB(0x6C, 0x6C, 0xFC)),
    /* 0b00110110 */ _PIXELS(_RGB(0x6C, 0x6C, 0xFC), _RGB(0x6C, 0x6C, 0xFC)),
    /* 0b00110111 */ _PIXELS(_RGB(0x6C, 0x6C, 0xFC), _RGB(0x6C, 0x6C, 0xFC)),
    /* 0b00111000 */ _PIXELS(_RGB(0x90, 0xFC, 0xB4), _RGB(0x90, 0xFC, 0xB4)),
    /* 0b00111001 */ _PIXELS(_RGB(0x90, 0xFC, 0xB4), _RGB(0x90, 0xFC, 0xB4)),
    /* 0b00111010 */ _PIXELS(_RGB(0x90, 0xFC, 0xB4), _RGB(0x90, 0xFC, 0xB4)),
    /* 0b00111011 */ _PIXELS(_RGB(0x90, 0xFC, 0xB4), _RGB(0x90, 0xFC, 0xB4)),
    /* 0b00111100 */ _PIXELS(RGB_WHITE, RGB_WHITE),
    /* 0b00111101 */ _PIXELS(RGB_WHITE, RGB_WHITE),
    /* 0b00111110 */ _PIXELS(RGB_WHITE, RGB_WHITE),
    /* 0b00111111 */ _PIXELS(RGB_WHITE, RGB_WHITE),
    /* 0b01000000 */ _PIXELS(RGB_BLACK, RGB_BLACK),
    /* 0b01000001 */ _PIXELS(RGB_BLACK, RGB_BLACK),
    /* 0b01000010 */ _PIXELS(RGB_BLACK, RGB_BLACK),
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
    /* 0b11010110 */ _PIXELS(_RGB(0x6C, 0x6C, 0xD8), _RGB(0x6C, 0x6C, 0xFC)),
    /* 0b11010111 */ _PIXELS(_RGB(0x6C, 0x6C, 0xD8), _RGB(0x6C, 0x6C, 0xFC)),
    /* 0b11011000 */ _PIXELS(_RGB(0xD8, 0xD8, 0x00), _RGB(0xD8, 0xD8, 0x00)),
    /* 0b11011001 */ _PIXELS(_RGB(0xD8, 0xD8, 0x00), _RGB(0xD8, 0xD8, 0x00)),
    /* 0b11011010 */ _PIXELS(_RGB(0xFC, 0xFC, 0xB4), _RGB(0xFC, 0xFC, 0xD8)),
    /* 0b11011011 */ _PIXELS(_RGB(0xFC, 0xFC, 0xB4), _RGB(0xFC, 0xFC, 0xD8)),
    /* 0b11011100 */ _PIXELS(_RGB(0xD8, 0xD8, 0x00), _RGB(0xD8, 0xD8, 0x00)),
    /* 0b11011101 */ _PIXELS(_RGB(0xD8, 0xD8, 0x00), _RGB(0xD8, 0xD8, 0x00)),
    /* 0b11011110 */ _PIXELS(RGB_WHITE, RGB_WHITE),
    /* 0b11011111 */ _PIXELS(RGB_WHITE, RGB_WHITE),
    /* 0b11100000 */ _PIXELS(RGB_BLACK, RGB_BLACK),
    /* 0b11100001 */ _PIXELS(RGB_BLACK, RGB_BLACK),
    /* 0b11100010 */ _PIXELS(_RGB(0xB4, 0x24, 0xFC), _RGB(0xB4, 0x24, 0xFC)),
    /* 0b11100011 */ _PIXELS(RGB_BLACK, RGB_BLACK), //_PIXELS(_RGB(0xB4, 0x24, 0xFC), _RGB(0x6C, 0x48, 0xFC)),
    /* 0b11100100 */ _PIXELS(_RGB(0xB4, 0x24, 0xFC), _RGB(0xB4, 0x24, 0xFC)),
    /* 0b11100101 */ _PIXELS(_RGB(0xB4, 0x24, 0xFC), _RGB(0x6C, 0x48, 0xFC)),
    /* 0b11100110 */ _PIXELS(_RGB(0xB4, 0x24, 0xFC), _RGB(0xB4, 0x24, 0xFC)),
    /* 0b11100111 */ _PIXELS(RGB_BLACK, RGB_BLACK), //_PIXELS(_RGB(0xB4, 0x24, 0xFC), _RGB(0x6C, 0x48, 0xFC)),
    /* 0b11101000 */ _PIXELS(RGB_PINK, RGB_PINK),
    /* 0b11101001 */ _PIXELS(RGB_PINK, _RGB(0xFC, 0xD8, 0xFC)),
    /* 0b11101010 */ _PIXELS(RGB_PINK, RGB_PINK),
    /* 0b11101011 */ _PIXELS(RGB_PINK, _RGB(0xFC, 0xD8, 0xFC)),
    /* 0b11101100 */ _PIXELS(RGB_PINK, RGB_PINK),
    /* 0b11101101 */ _PIXELS(RGB_PINK, _RGB(0xFC, 0xD8, 0xFC)),
    /* 0b11101110 */ _PIXELS(RGB_PINK, RGB_PINK),
    /* 0b11101111 */ _PIXELS(RGB_PINK, RGB_WHITE),
    /* 0b11110000 */ _PIXELS(RGB_WHITE, RGB_BLACK),
    /* 0b11110001 */ _PIXELS(RGB_WHITE, _RGB(0x6C, 0x6C, 0xFC)),
    /* 0b11110010 */ _PIXELS(RGB_WHITE, _RGB(0x6C, 0x6C, 0xFC)),
    /* 0b11110011 */ _PIXELS(RGB_WHITE, _RGB(0x6C, 0x6C, 0xFC)),
    /* 0b11110100 */ _PIXELS(RGB_WHITE, _RGB(0x6C, 0x6C, 0xFC)),
    /* 0b11110101 */ _PIXELS(RGB_WHITE, _RGB(0x6C, 0x6C, 0xFC)),
    /* 0b11110110 */ _PIXELS(RGB_WHITE, _RGB(0x6C, 0x6C, 0xFC)),
    /* 0b11110111 */ _PIXELS(RGB_WHITE, _RGB(0x6C, 0x6C, 0xFC)),
    /* 0b11111000 */ _PIXELS(RGB_WHITE, RGB_WHITE),
    /* 0b11111001 */ _PIXELS(RGB_WHITE, RGB_WHITE),
    /* 0b11111010 */ _PIXELS(RGB_WHITE, RGB_WHITE),
    /* 0b11111011 */ _PIXELS(RGB_WHITE, RGB_WHITE),
    /* 0b11111100 */ _PIXELS(RGB_WHITE, RGB_WHITE),
    /* 0b11111101 */ _PIXELS(RGB_WHITE, RGB_WHITE),
    /* 0b11111110 */ _PIXELS(RGB_WHITE, RGB_WHITE),
    /* 0b11111111 */ _PIXELS(RGB_WHITE, RGB_WHITE),
};
#undef _PIXELS
