Tronix286/a2vga_audio/firmware/analog-firmware-main-lc-4ns-vga/vga/hires_dot_patterns.h

#pragma once

#include "common/config.h"
#include <stdint.h>

// Mapping of a hires video byte to 14 half-pixel dots.
// Bits are displayed from MSB to LSB.
static uint16_t DELAYED_COPY_DATA(hires_dot_patterns)[256] = {
    0x0000,0x3000,0x0c00,0x3c00,0x0300,0x3300,0x0f00,0x3f00,
    0x00c0,0x30c0,0x0cc0,0x3cc0,0x03c0,0x33c0,0x0fc0,0x3fc0,
    0x0030,0x3030,0x0c30,0x3c30,0x0330,0x3330,0x0f30,0x3f30,
    0x00f0,0x30f0,0x0cf0,0x3cf0,0x03f0,0x33f0,0x0ff0,0x3ff0,
    0x000c,0x300c,0x0c0c,0x3c0c,0x030c,0x330c,0x0f0c,0x3f0c,
    0x00cc,0x30cc,0x0ccc,0x3ccc,0x03cc,0x33cc,0x0fcc,0x3fcc,
    0x003c,0x303c,0x0c3c,0x3c3c,0x033c,0x333c,0x0f3c,0x3f3c,
    0x00fc,0x30fc,0x0cfc,0x3cfc,0x03fc,0x33fc,0x0ffc,0x3ffc,
    0x0003,0x3003,0x0c03,0x3c03,0x0303,0x3303,0x0f03,0x3f03,
    0x00c3,0x30c3,0x0cc3,0x3cc3,0x03c3,0x33c3,0x0fc3,0x3fc3,
    0x0033,0x3033,0x0c33,0x3c33,0x0333,0x3333,0x0f33,0x3f33,
    0x00f3,0x30f3,0x0cf3,0x3cf3,0x03f3,0x33f3,0x0ff3,0x3ff3,
    0x000f,0x300f,0x0c0f,0x3c0f,0x030f,0x330f,0x0f0f,0x3f0f,
    0x00cf,0x30cf,0x0ccf,0x3ccf,0x03cf,0x33cf,0x0fcf,0x3fcf,
    0x003f,0x303f,0x0c3f,0x3c3f,0x033f,0x333f,0x0f3f,0x3f3f,
    0x00ff,0x30ff,0x0cff,0x3cff,0x03ff,0x33ff,0x0fff,0x3fff,
    0x0000,0x1800,0x0600,0x1e00,0x0180,0x1980,0x0780,0x1f80,
    0x0060,0x1860,0x0660,0x1e60,0x01e0,0x19e0,0x07e0,0x1fe0,
    0x0018,0x1818,0x0618,0x1e18,0x0198,0x1998,0x0798,0x1f98,
    0x0078,0x1878,0x0678,0x1e78,0x01f8,0x19f8,0x07f8,0x1ff8,
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
    0b0000110000000000,0b0000110000000011,0b0000110000001100,0b0000110000001111,0b0000110000110000,0b0000110000110011,0b0000110000111100,0b0000110000111111,
    0b0000110011000000,0b0000110011000011,0b0000110011001100,0b0000110011001111,0b0000110011110000,0b0000110011110011,0b0000110011111100,0b0000110011111111,
    0b0000111100000000,0b0000111100000011,0b0000111100001100,0b0000111100001111,0b0000111100110000,0b0000111100110011,0b0000111100111100,0b0000111100111111,
    0b0000111111000000,0b0000111111000011,0b0000111111001100,0b0000111111001111,0b0000111111110000,0b0000111111110011,0b0000111111111100,0b0000111111111111,
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
};
