Tronix286/a2vga_audio/firmware/analog-firmware-main-lc-4ns-vga/z80/z80rom.h

uint8_t z80_rom[2*1024] = {
0x18, 0x71, 0x5a, 0x38, 0x30, 0x09, 0x4a, 0x25, 0x00, 0x00, 0x21, 0x00, 0x10, 0x0e, 0x01, 0x18,
0x02, 0x0e, 0x02, 0xe5, 0xdd, 0xe1, 0x11, 0xe0, 0x00, 0xdd, 0x19, 0xdd, 0xe9, 0x00, 0x2a, 0x2a,
0x20, 0x43, 0x6f, 0x70, 0x79, 0x72, 0x69, 0x67, 0x68, 0x74, 0x20, 0x28, 0x63, 0x29, 0x20, 0x31,
0x39, 0x38, 0x32, 0x20, 0x50, 0x65, 0x72, 0x73, 0x6f, 0x6e, 0x6e, 0x65, 0x6c, 0x20, 0x43, 0x6f,
0x6d, 0x70, 0x75, 0x74, 0x65, 0x72, 0x20, 0x50, 0x72, 0x6f, 0x64, 0x75, 0x63, 0x74, 0x73, 0x2c,
0x20, 0x49, 0x6e, 0x63, 0x2e, 0x20, 0x20, 0x2a, 0x2a, 0x02, 0x00, 0x00, 0x00, 0x00, 0x00, 0x00,
0x00, 0x00, 0x00, 0x00, 0x00, 0x00, 0x31, 0xf9, 0xff, 0x3e, 0x02, 0xf5, 0x21, 0xd3, 0x00, 0xe5,
0xfb, 0xed, 0x45, 0x3e, 0x01, 0x18, 0x39, 0x3e, 0x3e, 0x20, 0x57, 0x69, 0x6e, 0x74, 0x68, 0x72,
0x6f, 0x70, 0x20, 0x4c, 0x2e, 0x20, 0x53, 0x61, 0x76, 0x69, 0x6c, 0x6c, 0x65, 0x20, 0x49, 0x49,
0x49, 0x20, 0x61, 0x6e, 0x64, 0x20, 0x52, 0x61, 0x79, 0x6d, 0x6f, 0x6e, 0x64, 0x20, 0x4b, 0x6c,
0x65, 0x69, 0x6e, 0x20, 0x2d, 0x20, 0x61, 0x75, 0x74, 0x68, 0x6f, 0x72, 0x73, 0x20, 0x3c, 0x3c,
0x06, 0x1f, 0x0e, 0xdf, 0xed, 0x41, 0x0d, 0x10, 0xfb, 0xed, 0x41, 0x31, 0xf9, 0xff, 0xf5, 0x3e,
0x7a, 0xd3, 0x00, 0x2a, 0xfe, 0xff, 0x11, 0xab, 0x55, 0x19, 0x7c, 0xb5, 0xc2, 0xd3, 0x00, 0xf1,
0xc3, 0x6c, 0x02, 0x3e, 0x31, 0xd3, 0x00, 0x3e, 0x32, 0xd3, 0x00, 0x21, 0x00, 0x00, 0x0e, 0x03,
0x11, 0xff, 0x07, 0x06, 0x00, 0x78, 0x86, 0x47, 0x23, 0x1b, 0x7a, 0xb3, 0x20, 0xf7, 0x70, 0x7e,
0xb8, 0xf5, 0x79, 0xfe, 0x03, 0x28, 0x05, 0xe1, 0xfe, 0x02, 0xc8, 0xff, 0xf1, 0x28, 0x07, 0x3a,
0x1d, 0x00, 0xb7, 0xca, 0xae, 0x01, 0xf1, 0xfe, 0x01, 0xca, 0x6c, 0x02, 0x3e, 0x33, 0xd3, 0x00,
0x21, 0x00, 0x00, 0x11, 0x00, 0x80, 0x01, 0x00, 0x08, 0xed, 0xb0, 0xc3, 0x1e, 0x81, 0x3e, 0x00,
0xd3, 0x60, 0x0e, 0x00, 0x21, 0x00, 0x00, 0x11, 0x00, 0x80, 0x06, 0x43, 0x79, 0x80, 0x4f, 0x70,
0x04, 0x23, 0x1b, 0x7b, 0xb2, 0x20, 0xf5, 0x21, 0x00, 0x80, 0x11, 0x00, 0x08, 0x79, 0x86, 0x4f,
0x23, 0x1b, 0x7b, 0xb2, 0x20, 0xf7, 0x06, 0x43, 0x79, 0x80, 0x4f, 0x70, 0x04, 0x23, 0x7c, 0xb5,
0x20, 0xf6, 0x21, 0x00, 0x80, 0x2b, 0x7c, 0xb5, 0x20, 0xfb, 0x21, 0x00, 0x00, 0x06, 0x00, 0x78,
0x86, 0x47, 0x23, 0x7c, 0xb5, 0x20, 0xf8, 0x78, 0xb9, 0x20, 0x43, 0x3e, 0x34, 0xd3, 0x00, 0xc3,
0x72, 0x81, 0x3e, 0x00, 0xd3, 0x60, 0x21, 0x00, 0x00, 0xcd, 0xb9, 0x81, 0x21, 0x00, 0x80, 0x11,
0x00, 0x00, 0x01, 0x00, 0x08, 0xed, 0xb0, 0x21, 0x00, 0x00, 0x06, 0x00, 0x11, 0xff, 0x07, 0x78,
0x86, 0x47, 0x23, 0x1b, 0x7a, 0xb3, 0x20, 0xf7, 0x78, 0xbe, 0x20, 0x12, 0xc3, 0x9f, 0x01, 0x31,
0xf9, 0x7f, 0x21, 0x00, 0x80, 0xcd, 0xb9, 0x01, 0x31, 0xf9, 0xff, 0xc3, 0xe4, 0x01, 0xf3, 0x21,
0xff, 0xff, 0xdb, 0xe0, 0x7e, 0x00, 0x77, 0x18, 0xf9, 0x11, 0x00, 0x80, 0x3e, 0x55, 0x77, 0xbe,
0x20, 0xec, 0x3e, 0xaa, 0x77, 0xbe, 0x20, 0xe6, 0x3e, 0xff, 0x77, 0xbe, 0x20, 0xe0, 0x3e, 0x00,
0x77, 0xbe, 0x20, 0xda, 0x3e, 0x01, 0x77, 0xbe, 0x20, 0xd4, 0x07, 0x30, 0xf9, 0x23, 0x1b, 0x7a,
0xb3, 0x20, 0xd9, 0xc9, 0x3e, 0x35, 0xd3, 0x00, 0x3e, 0x00, 0xd3, 0x80, 0x3e, 0x27, 0xd3, 0x80,
0x3e, 0xff, 0xd3, 0x80, 0x06, 0x00, 0xdb, 0x80, 0xfe, 0xfd, 0xca, 0x07, 0x02, 0x00, 0x00, 0x00,
0x04, 0xc2, 0xf6, 0x01, 0xc3, 0x61, 0x02, 0x06, 0x00, 0xdb, 0x80, 0xfe, 0xfd, 0xca, 0x18, 0x02,
0xfe, 0xfc, 0xca, 0x1f, 0x02, 0xc3, 0x61, 0x02, 0x04, 0xc2, 0x09, 0x02, 0xc3, 0x61, 0x02, 0x3e,
0x36, 0xd3, 0x00, 0xed, 0x5e, 0x3e, 0x90, 0xed, 0x47, 0x21, 0x00, 0x90, 0x36, 0xae, 0x2c, 0x36,
0x01, 0x2c, 0xc2, 0x2c, 0x02, 0x21, 0x68, 0x02, 0x22, 0x02, 0x90, 0x11, 0x00, 0x00, 0x3e, 0x87,
0xd3, 0x81, 0x3e, 0x80, 0xd3, 0x81, 0xfb, 0x21, 0x14, 0x05, 0x2b, 0x7c, 0xb5, 0xc2, 0x4a, 0x02,
0xf3, 0x3e, 0x07, 0xd3, 0x81, 0x3e, 0x00, 0xd3, 0x81, 0x21, 0x0a, 0x00, 0xed, 0x52, 0xf2, 0xae,
0x01, 0x3e, 0x01, 0xd3, 0x60, 0xc3, 0x6c, 0x02, 0x13, 0xfb, 0xed, 0x4d, 0x21, 0x55, 0xaa, 0x22,
0xfe, 0xff, 0x3e, 0x5a, 0xd3, 0x00, 0x11, 0xa0, 0x00, 0x21, 0x00, 0x00, 0xdb, 0x40, 0x17, 0x38,
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
};
